ZeniteSolar/MCS17/README.md

# Módulo de Carregamento do Sistema 2017
Versão do carregamento do sistema da embarcação Guarapuvu II (Zênite Solar) para o DSB 2017.
