ZeniteSolar/MCS17/(list of files, drawings)

Other design files:
hardware/atmega.SchDoc
hardware/main.SchDoc
hardware/MCS17.PcbDoc
hardware/MCS17.PrjPCB
hardware/MCS17.SchDoc
hardware/pre_carga_analogica.SchDoc
hardware/pre_carga_analogica_.SchDoc
hardware/pre_carga_logica.SchDoc
hardware/relays.SchDoc
hardware/signals.SchDoc
hardware/Zenite_Symbols.SchLib
