ZeniteSolar/MCS17/firmware/src/main.c

// coding: utf-8

#include "main.h"

int main(void)
{
    #ifdef USART_ON
        usart_init(MYUBRR,1,1);                         // inicializa a usart
        VERBOSE_MSG_INIT(usart_send_string("\n\n\nUSART... OK!\n"));
    #endif

    _delay_ms(1000);

    #ifdef CAN_ON
        VERBOSE_MSG_INIT(usart_send_string("CAN (500kbps)..."));
        can_init(BITRATE_500_KBPS);
        VERBOSE_MSG_INIT(usart_send_string(" OK!\n"));
        VERBOSE_MSG_INIT(usart_send_string("CAN filters..."));
        can_static_filter(can_filter);
        VERBOSE_MSG_INIT(usart_send_string(" OK!\n"));
    #endif

    #ifdef ADC_ON
        VERBOSE_MSG_INIT(usart_send_string("ADC..."));
        adc_init();
        VERBOSE_MSG_INIT(usart_send_string(" OK!\n"));
    #endif


    #ifdef SLEEP_ON 
        VERBOSE_MSG_INIT(usart_send_string("SLEEP..."));
        sleep_init();
        VERBOSE_MSG_INIT(usart_send_string(" OK!\n"));
    #endif

    #ifdef WATCHDOG_ON
        VERBOSE_MSG_INIT(usart_send_string("WATCHDOG..."));
        wdt_init();
        VERBOSE_MSG_INIT(usart_send_string(" OK!\n"));
    #endif

 	#ifdef MACHINE_ON
        VERBOSE_MSG_INIT(usart_send_string("MACHINE..."));
		machine_init();
        VERBOSE_MSG_INIT(usart_send_string(" OK!\n"));
	#endif

    set_bit(LED_DDR, LED);                      // LED as output
    set_bit(RELAY0_DDR, RELAY0);                // RELAY0 as output
    set_bit(RELAYS_1_5_DDR, RELAY1);            // RELAY1 as output
    set_bit(RELAYS_1_5_DDR, RELAY2);            // RELAY2 as output
    set_bit(RELAYS_1_5_DDR, RELAY3);            // RELAY3 as output
    set_bit(RELAYS_1_5_DDR, RELAY4);            // RELAY4 as output
    set_bit(RELAYS_1_5_DDR, RELAY5);            // RELAY5 as output
    set_bit(MAINRELAY_DDR, MAINRELAY_ON);       // MAINRELAY_ON as output
    set_bit(MAINRELAY_DDR, MAINRELAY_OFF);      // MAINRELAY_OFF as output

    sei();
	
	for(;;){
		#ifdef WATCHDOG_ON
            wdt_reset();
		#endif

        #ifdef MACHINE_ON
            machine_run();
        #endif

		#ifdef SLEEP_ON
            sleep_mode();
		#endif
	}
}


/**
 * @brief se em debug, fica chaveando os pinos de debugs até o reset do watchdog
 */
ISR(BADISR_vect)
{
    for(;;){
        VERBOSE_MSG_ERROR(usart_send_string("\nFATAL ERROR: BAD ISR."));
        #ifdef WATCHDOG_ON
            VERBOSE_MSG_ERROR(usart_send_string("WAITING FOR WATCHDOG TO RESET...\n"));
        #endif
        #ifdef DEBUG_ON
            DEBUG0;
            DEBUG1;
            _delay_ms(100);
        #endif
    }
}
