ZeniteSolar/MCS17/firmware/src/machine.h

/**
 * @file machine.h
 *
 * @defgroup MACHINE State Machine Module
 *
 * @brief Implements the main state machine of the system.
 *
 */

#ifndef MACHINE_H
#define MACHINE_H 

#include <avr/io.h>
#include <avr/wdt.h>
#include <util/delay.h>

#include "conf.h"
#include "adc.h"
#include "usart.h"
#include "dbg_vrb.h"
#ifdef CAN_ON
#include "can.h"
#include "can_app.h"
extern const uint8_t can_filter[];
#endif

typedef enum state_machine{
    STATE_INITIALIZING,
    STATE_IDLE,
    STATE_RUNNING,
    STATE_ERROR,
} state_machine_t;

typedef union system_flags{
    struct{
        uint8_t     boat_on        :1;
        uint8_t     boat_on_before :1;
    };
    uint8_t   all__;
} system_flags_t;

typedef union error_flags{
    struct{
        uint8_t     no_canbus   :1;
    };
    uint8_t   all;
}error_flags_t;

typedef struct control{
    uint8_t     Vbat;          // value from 0 to 255
}control_t;

control_t control;

// debug functions
void print_system_flags(void);
void print_error_flags(void);
void print_control(void);

// machine tasks
void task_initializing(void);
void task_idle(void);
void task_running(void);
void task_error(void);

// the machine itself
void machine_init(void);
void machine_run(void);
void set_state_error(void);
void set_state_initializing(void);
void set_state_idle(void);
void set_state_running(void);

// machine variables
state_machine_t state_machine;
system_flags_t system_flags;
error_flags_t error_flags;
volatile uint8_t machine_clk;
uint8_t total_errors;   // Contagem de ERROS

// other variables
uint8_t led_clk_div;

// ISRs
ISR(TIMER2_COMPA_vect);
ISR(PCINT2_vect);

#endif /* ifndef MACHINE_H */
