ZeniteSolar/MCS17/firmware/src/can_app.h

/**
 * @file can_app.h
 *
 * @defgroup CANAPP    Application Module for canbus
 *
 * @brief The application layer module for canbus
 *
 */

#ifndef CAN_APP_H
#define CAN_APP_H 

#include "conf.h"
#include "machine.h"
#include "can.h"
#include "can_ids.h"
#include "usart.h"
#include "dbg_vrb.h"
#include "../lib/bit_utils.h"

void can_app_print_msg(can_t *msg);
void can_app_task(void);
void can_app_send_state(void);
void can_app_send_mcs(void);
void can_app_extractor_mic17_state(can_t *msg);
void can_app_extractor_mic17_mcs(can_t *msg);
void can_app_msg_extractors_switch(can_t *msg);
void check_can(void);

#define CAN_APP_SEND_STATE_CLK_DIV  100
#define CAN_APP_SEND_MCS_CLK_DIV  50

uint8_t can_app_send_state_clk_div;
uint8_t can_app_send_mcs_clk_div;
uint16_t can_app_checks_without_mic17_msg;
#define CAN_APP_CHECKS_WITHOUT_MIC17_MSG 100

#endif /* ifndef CAN_APP_H */
