ZeniteSolar/MCS17/(commit log)

2017-12-07 Initial commit.
    [MCS17.PcbDoc, MCS17.PrjPCB, MCS17.SchDoc, Zenite_Symbols.SchLib, atmega.SchDoc, main.SchDoc, pre_carga_analogica.SchDoc, pre_carga_analogica_.SchDoc]
2017-12-07 Pump pins and macros added.
2017-12-07 macros for relay0 and mainrelay, extractors and senders was made.
2017-12-13 canbus filters and masks updated.
2017-12-13 relay macros fixed
2017-12-13 basic functions for main relay added
